toni-lc/sonda/(commit log)

2026-08-08 change board to uno
2026-08-08 add flags for sensors/output and define environments
